joaoantoniocardoso/sct2_projeto1/README.md

# sct2_projeto1
Primeiro projeto de controlador digital da disciplina de Sistemas de Controles 2

Relatório: [Relatorio.pdf](Relatorio.pdf)
