joaoantoniocardoso/sct2_projeto1/controle/SCT2_bloco1/ALL0000/F0000TEK.JPG

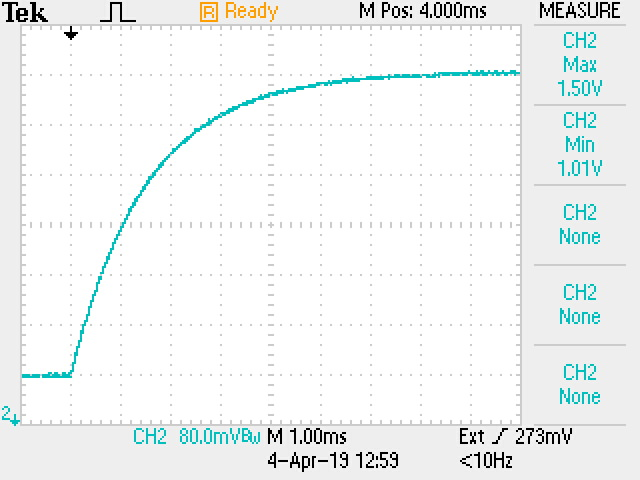
controle/SCT2_bloco1/ALL0000/F0000TEK.JPG
