joaoantoniocardoso/sct2_projeto1/controle/SCT2_bloco1/ALL0001/F0001TEK.JPG

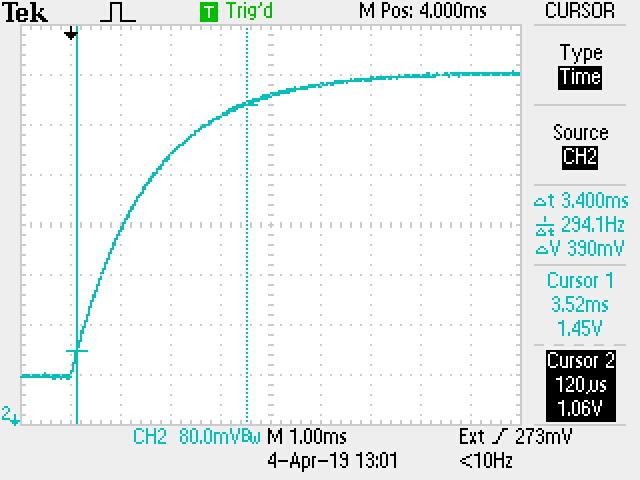
controle/SCT2_bloco1/ALL0001/F0001TEK.JPG
