joaoantoniocardoso/sct2_projeto1/controle/SCT2_bloco2/ALL0002/F0002TEK.JPG

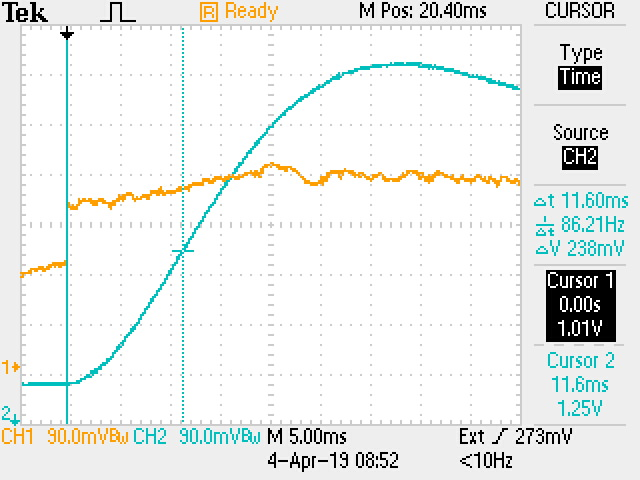
controle/SCT2_bloco2/ALL0002/F0002TEK.JPG
