joaoantoniocardoso/sct2_projeto1/controle/SCT2_bloco2/ALL0003/F0003TEK.JPG

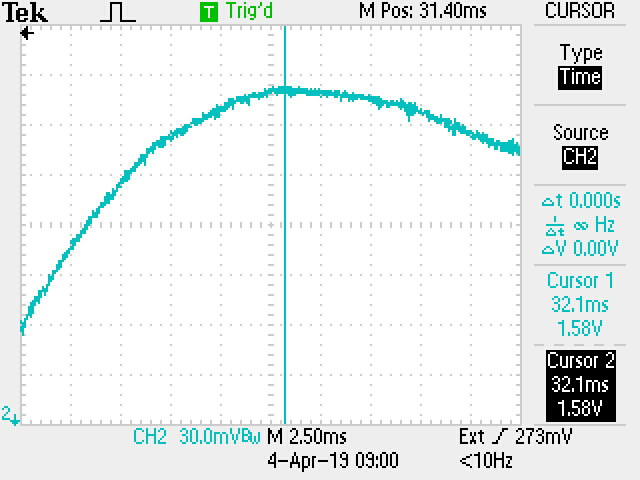
controle/SCT2_bloco2/ALL0003/F0003TEK.JPG
