joaoantoniocardoso/sct2_projeto1/controle/SCT2_bloco2/ALL0004/F0004TEK.JPG

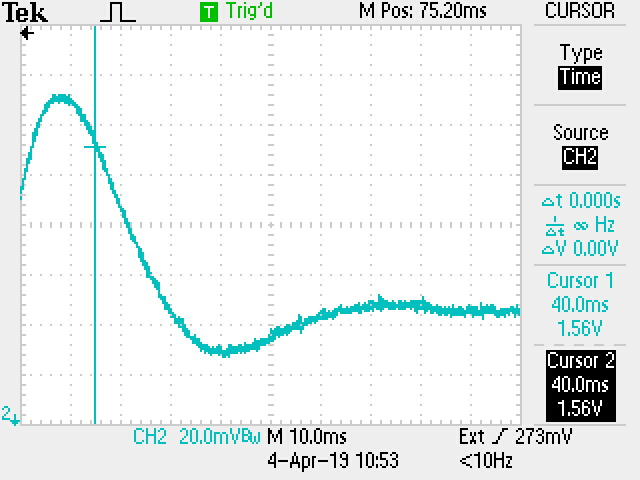
controle/SCT2_bloco2/ALL0004/F0004TEK.JPG
