joaoantoniocardoso/sct2_projeto1/controle/SCT_bloco1ord/ALL0003/F0003TEK.JPG

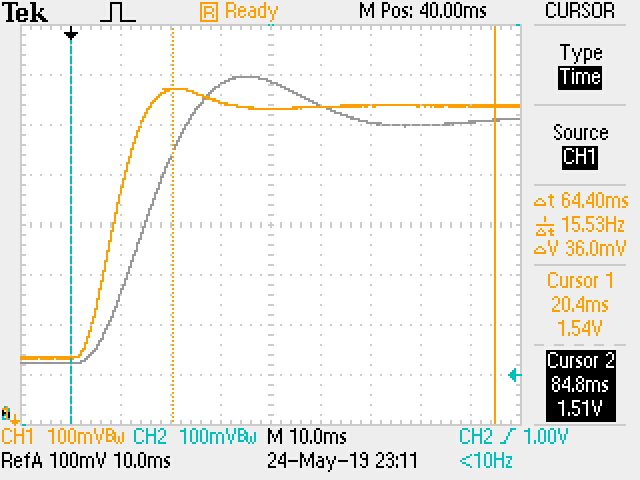
controle/SCT_bloco1ord/ALL0003/F0003TEK.JPG
