joaoantoniocardoso/sct2_projeto1/controle/SCT_completo/ALL0000/F0000TEK.JPG

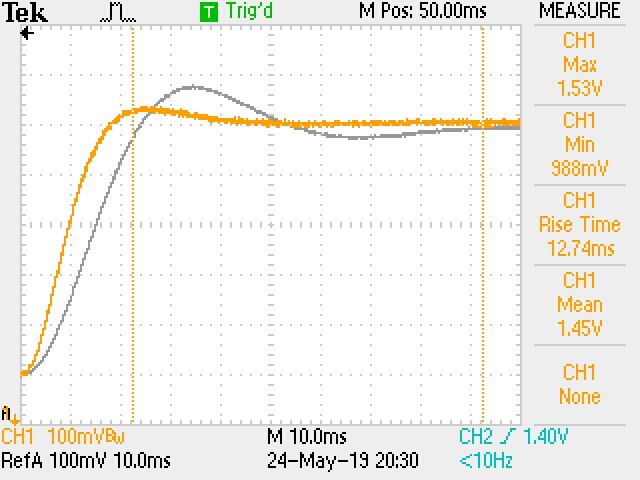
controle/SCT_completo/ALL0000/F0000TEK.JPG
