joaoantoniocardoso/sct2_projeto1/controle/SCT_controlado/ALL0002/F0002TEK.JPG

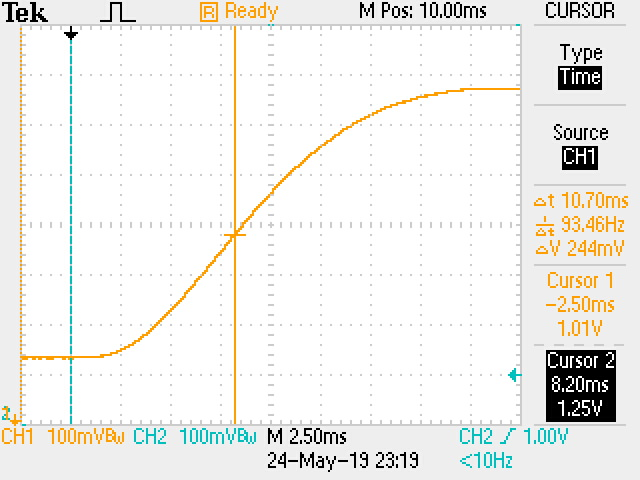
controle/SCT_controlado/ALL0002/F0002TEK.JPG
