joaoantoniocardoso/sct2_projeto1/controle/SCT_controlado/ALL0004/F0004TEK.JPG

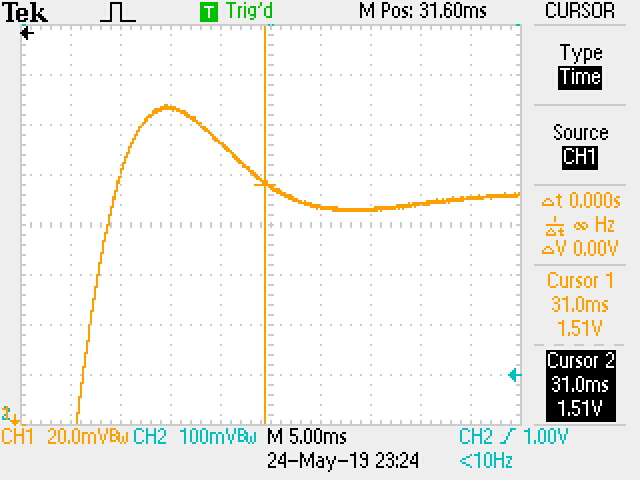
controle/SCT_controlado/ALL0004/F0004TEK.JPG
