joaoantoniocardoso/sct2_projeto1/f28335_ccs7/ExperimentersKit-HWdevPkg/USBDockingStation_BOM [R3].xls

USB-Docking Stn [R3]
 |  |  |  | For planning purposes |  |  | Notes
Item | Description | Digikey Part # | Mouser Part # | Qty | price | ext Price
U1 | FT2232D | 768-1010-1 |  | 1 | $4.00 | $4.00
U2 | TPS79533 - Linear 3.3 Vreg | 296-13810-1 |  | 1 | $1.26 | $1.26
U3 | 93LC46BT SOT23-6 | 93LC46BT-I/OTCT |  | 1 | $0.20 | $0.20
U4 | SN74LVC2G74 SM8 | 296-13273-1 |  | 1 | $0.15 | $0.15
LD1 | LED Green 0805 | 404-1021-1 |  | 1 | $0.03 | $0.03
DA1 | BAW567 Quad Diode Array SOT363 | BAW567DWDICT |  | 1 | $0.26 | $0.26
C1 | CAP ceramic 10u X5R, SMD 0805 | PCC2225TR |  | 1 | $0.05 | $0.05
C2 | CAP ceramic 4u7 X5R, SMD 0805 | 587-1302-2 |  | 1 | $0.05 | $0.05
C3 | CAP ceramic 100n X5R, SMD 0805 | PCC1828TR |  | 1 | $0.01 | $0.01
C4, C5 | CAP ceramic 1u X5R, SMD 0603 | 490-1549-1 |  | 2 | $0.02 | $0.04
C6, C7, C8, C9, C10, C11, C12 | CAP ceramic 100n X5R, SMD 0603 | 587-1245-1 |  | 7 | $0.01 | $0.07
L1 | Inductor 22uH SMD, 0805 | 490-4030-1 |  | 1 | $0.05 | $0.05
X1 | Resonator 6MHz SMD 3 pin | 490-1218-1 |  | 1 | $0.17 | $0.17
R1, R9 | Resistors 470R, 5% - SMD, 0603 |  |  | 2 | $0.01 | $0.02
R2, R3 | Resistors 27R, 5% - SMD, 0603 |  |  | 2 | $0.01 | $0.02
R4, R6 | Resistors 2K2, 5% - SMD, 0603 |  |  | 2 | $0.01 | $0.02
R5 | Resistors 1M, 5% - SMD, 0603 |  |  | 1 | $0.01 | $0.01
R7 | Resistors 10K, 5% - SMD, 0603 |  |  | 1 | $0.01 | $0.01
R8 | Resistors 1K, 5% - SMD, 0603 |  |  | 1 | $0.01 | $0.01
R13 | Resistors 47K, 5% - SMD, 0603 |  |  | 1 | $0.01 | $0.01
R10, R11, R12, R15, R16, R17, R18 | Resistors 2K7, 5% - SMD, 0603 |  |  | 7 | $0.01 | $0.07
R14 | Resistors 1K5, 5% - SMD, 0603 |  |  | 1 | $0.01 | $0.01
SW1 | Miniture SPDT switch PCB mount |  | 108-2AS1T1203-EVX | 1 | $1.97 | $1.97
JP1 | Power jack 2.5 x 5.5 mm | CP-002BH |  | 1 | $0.24 | $0.24
JP2 | USB Connector Type B PCB mount | ED90064 |  | 1 | $0.73 | $0.73
J1 | 100 pin DIMM socket - Molex 0876301001 |  | 538-87630-1001 | 1 | $0.68 | $0.68
J2 | standard 0.1" pin (DIL) headers 14 pin (2x7) |  |  |  |  |  | Remove pin 6
J3, 4,5,6,7 | standard 0.1" pin (SIL) headers cut to length
J8 | standard 0.1" 2 pin (SIL)
Boot-280xx | standard 0.1" pin headers 9 pins (3x3) |  |  |  |  |  | Make up with SIL or other combination
Boot-2833x | standard 0.1" pin headers 12 pins (3x4) |  |  |  |  |  | Make up with SIL or other combination
GND x 4 | standard 0.1" pin (SIL) headers cut to length
3V3 x 2 | standard 0.1" pin (SIL) headers cut to length
5V x 1 | standard 0.1" pin (SIL) headers cut to length
Rubber Feet | Bumpon hemisphere 0.44”x 0.2” Clear | SJ5303-7 |  | 4 | $0.06 | $0.24
 |  | TOTAL |  |  |  | $10.38
