joaoantoniocardoso/sct2_projeto1/f28335_ccs7/CC2833xHWdevPkg/F28335controlCARD HWDevPkg PGF [R1.0]/F28335controlCARD-BOM(R2) 5-27.xls

F28335 controlCARD BOM - Rel 2
Updated May 27, 2010
Item | Description | Digikey Part #
C1-15, C34,36, 39-51 | CAP ceramic 100n X5R SMD 0603
C32 | CAP ceramic 100n X5R SMD 0603
C16-C27 | CAP ceramic 3n3 X5R SMD 0603
C30,31 | CAP ceramic 2u2 X7R SMD 0603
C33,C53,C54 | CAP ceramic 33p X7R SMD 0603
C28,29 | CAP ceramic 10u 6.3V X5R SMD 1206 | 490-1806-2
C37, 38 | CAP ceramic 22u X5R SMD1206 | 587-1334-2
C35, C52 | CAP Tant 47u 10V SMD (3216-12) | 511-1500-2
L1-L18 | Inductor 22uH SMD 0805 | 490-1054-1-ND
L19 | Inductor 2u2H SMD (see data sheet) | 445-3215-2 | Note: If not in stock, use 3u3 H
L20 | Inductor 3u3H SMD (see data sheet) | 445-3216-2
R2 | Resistors 22K1, 1% - SMD, 0603
R8 | Resistors 220K, 1% - SMD, 0603
R9 | Resistors 48K7, 1% - SMD, 0603
R10 | Resistors 147K, 1% - SMD, 0603
R11 | Resistors 68K0, 1% - SMD, 0603
R15 | Resistors 2k2, 5% - SMD, 0603
R13 | Resistors 0R 5% - SMD, 0805
R6,7,21 | Resistors 680R, 5% - SMD, 0603
R17 | Resistors 2K, 5% - SMD, 0603
R18 | Resistors 22K, 5% - SMD, 0603
R19 | Resistors 10K, 5% - SMD, 0603
R20 | Resistors 0R 5% - SMD, 0603 (Do NOT populate)
R33 | Resistor 0R 5% - SMD, 0603
R34 | Resistors 0R 5% - SMD, 0603 (Do NOT populate)
R22, 23 | Resistors 4K7, 5% - SMD, 0603
R24 | Resistors 0R 5% - SMD, 0805
R25, R26, R27, R28 | Resistors 820R, 1% - SMD, 0603
R29, R30, R31, R32 | Resistors 3K3, 1% - SMD, 0603
SW2 | 4 switch pack | Manf part number (CT2184LPST)
SW1 | switch | 563-1004-1-ND
RN1,2 | Resistor network 56R 5% - SMD, as small as needed | Y1560CT
RN3 | Resistor network 33R 5% - SMD, as small as needed | Y1330CT
X1 | crystal - 30 MHz - SMD (NX5032GA-30) | 644-1043-1-ND
DN1,2,3 | Diodes, clamping, NUP4201MR6 TSOP-6 | NUP4201MR6T1GOSTR
LD1 | LED SMD 0805 - Green | 404-1021-1
LD2,3 | LEDs SMD 0805 - Red | 404-1017-1
U1 | TMS320F2833x (TI) SMD (176 BGA "ZJZ") or (176 pin LQFP "PGF" package (non socketed))
U2 | TPS62400-DRCT (TI) | 296-20690-1
U4 | ISO7221CDR (TI) | 296-21955-1
U3 | SN74LVC2G07 (TI) | 296-13494-2
U5 | MAX3221 (TI) | 296-19825-2
U6 | TPS3828-DBVT (TI) | 296-2638-1
