joaoantoniocardoso/sct2_projeto1/hardware/main/main.pdf

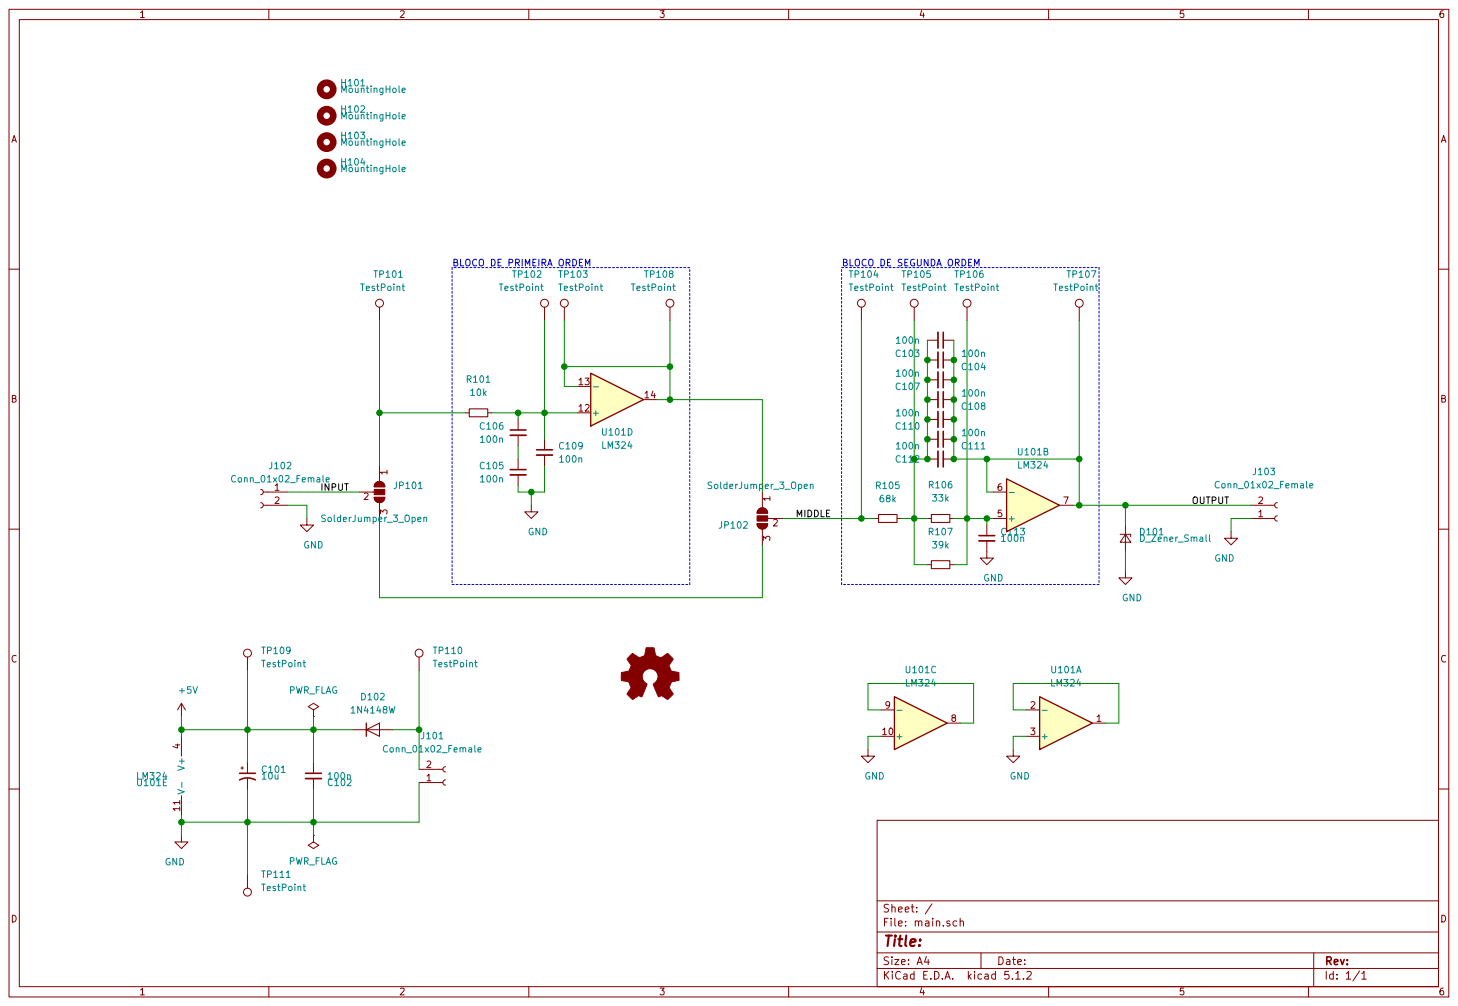
[picture p45: page 1]

Id: 1/1 Title: File: main.sch Sheet: / R105
