joaoantoniocardoso/sct2_projeto1/hardware/simulations/Draft1.asc

C1: cap; 1p
R1: res; 50
R2: res; 50
V1: voltage-; PULSE(0 5 0 13e-9 13e-9 2.5e-07 5e-07)
Named nets: 0, in, out
.tran 0 5000e-9 0 1e-8
