joaoantoniocardoso/sct2_projeto1/hardware/simulations/Draft2.asc

C1: cap; 150n
R1: res; 10k
R2: res; 10k
U1: LM324_NS
Named nets: 0, VCC, A, C
