joaoantoniocardoso/sct2_projeto1/hardware/simulations/planta_equivalente_alimentacao_simples.asc

C1: cap; 150n
C2: cap; 150n
R1: res; 10k
R2: res; 10k
R5: res; 10k
R6: res; 10k
R7: res; 10k
R8: res; 10k
sig1: voltage-; PULSE(0 3.3 0 1n 1n 500e-6 1000e-6)
sig: voltage-; ac 1
U1: LM324_NS
U3: LM324_NS
U4: LM324_NS
V1: voltage-; 5
V2: voltage-; 12
V3: voltage-; -5
Named nets: VCC, 0, VEE, B_, A, C_, C, VCC2
;.ac dec 10000 1 10000
.tran 0 0.04 0.01
