joaoantoniocardoso/sct2_projeto1/controle/spice/main.asc

C1: cap; 150n
C2: cap; 150n
C3: cap; 700n
R1: res; 10k
R3: res; 18k
R4: res; 68k
U1: LM324_NS
U2: LM324_NS
Named nets: 0, 5V, A, B, C
