joaoantoniocardoso/sct2_projeto1/(list of files, drawings)

Other design files:
f28335_ccs7/ExperimentersKit-HWdevPkg/!Legacy_DockingStation[R2]/BH28xxxDockingStn[R2].pcb
f28335_ccs7/ExperimentersKit-HWdevPkg/!Legacy_DockingStation[R2]/BH28xxxQuickSpinTemplate.pcb
f28335_ccs7/ExperimentersKit-HWdevPkg/USB-DockingStn[R3].pcb
