joaoantoniocardoso/sct2_projeto1/hardware/main/main.kicad_pcb

## KiCad design hardware/main/main.kicad_pcb (2019-05-27)

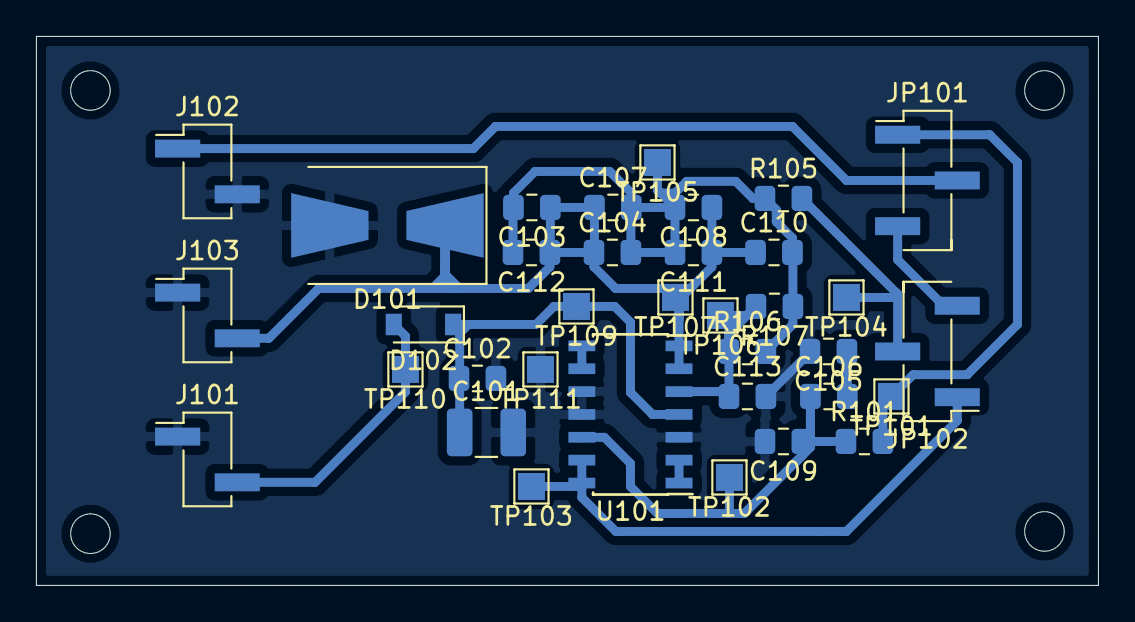
[picture p46: board main.kicad_pcb from below]

Board: 2 copper layers, 59.0 x 30.5 mm, 39 parts (35 on the bottom side), 15 nets.

Parts:
C101: 10u; C_1210_3225Metric_Pad1.42x2.65mm_HandSolder
C102, C103, C104, C105, C106, C107, C108, C109, C110, C111, C112, C113: 100n; C_0805_2012Metric_Pad1.15x1.40mm_HandSolder
D101: D_Zener_Small; D_SMB-SMC_Universal_Handsoldering
D102: 1N4148W; D_SOD-123
H101, H102, H103, H104: MountingHole; MountingHole_2.2mm_M2
J101, J102, J103: Conn_01x02_Female; PinHeader_1x02_P2.54mm_Vertical_SMD_Pin1Left
JP101, JP102: SolderJumper_3_Open; PinHeader_1x03_P2.54mm_Vertical_SMD_Pin1Left
R101: 10k; R_0805_2012Metric_Pad1.15x1.40mm_HandSolder
R105: 68k; R_0805_2012Metric_Pad1.15x1.40mm_HandSolder
R106: 33k; R_0805_2012Metric_Pad1.15x1.40mm_HandSolder
R107: 39k; R_0805_2012Metric_Pad1.15x1.40mm_HandSolder
TP101, TP102, TP103, TP104, TP105, TP106, TP107, TP109, TP110, TP111: TestPoint; TestPoint_Pad_1.5x1.5mm
U101: LM324; SOIC-14_3.9x8.7mm_P1.27mm

Connections:
+5V: C101.1, C102.1, D102.1, TP109.1, U101.4
/INPUT: J102.1, JP101.2
/MIDDLE: JP102.2, R105.2, TP104.1
/OUTPUT: C103.1, C104.1, C107.1, C108.1, C110.1, C111.1, C112.1, D101.1, J103.2, TP107.1, U101.6, U101.7
GND: C101.2, C102.2, C105.2, C109.2, C113.2, D101.2, J101.1, J102.2, J103.1, TP111.1, U101.3, U101.10, U101.11
unnamed: C103.2, C104.2, C107.2, C108.2, C110.2, C111.2, C112.2, R105.1, R106.2, R107.1, TP105.1
unnamed: C105.1, C106.2
unnamed: C106.1, C109.1, R101.1, TP102.1, U101.12
unnamed: C113.1, R106.1, R107.2, TP106.1, U101.5
unnamed: D102.2, J101.2, TP110.1
unnamed: JP101.1, R101.2, TP101.1
unnamed: JP101.3, JP102.3
unnamed: JP102.1, TP103.1, U101.13, U101.14
unnamed: U101.1, U101.2
unnamed: U101.8, U101.9
