joaoantoniocardoso/sct2_projeto1/f28335_ccs7/basic_F28335/main.c

/*
 * main.c
 *
 *  Created on: Jun 2, 2017
 *      Author: João Antônio Cardoso
 *
 *  Description: Firmware para o Projeto 1 de Sistemas de Controle 2
 *
 *  Instructions:
 *      1) Conectar a interrupção do pino GPIO60 como trigger no canal
 *      Ext. Trig. do osciloscópio
 *      2) Conectar a saída da planta no canal 1 do osciloscópio
 *      3) Conectar a saída epwm1 na entrada da planta e no canal 2 do
 *      osciloscópio
 *
 *  References: http://www.ti.com/product/TMS320F28335/technicaldocuments
 *
 */

#include "DSP28x_Project.h"
#include "my_adc.h"
#include "my_scia.h"
#include "my_epwm.h"
#include "my_debugpins.h"

#define MY_DEBUG_

//void serial_debug(void);

void init(void){

    DINT;   // Disable Global interrupt

    // Disable CPU interrupts and clear all CPU interrupt flags:
    IER = 0x0000;
    IFR = 0x0000;

    // É necessário para as funções que utilizam macros dos .asm, como o InitAdc.
    memcpy(&RamfuncsRunStart, &RamfuncsLoadStart, &RamfuncsLoadEnd - &RamfuncsLoadStart);
    InitFlash();    // call InitFlash in RAM (SARAM - L0)

    InitSysCtrl();

    InitPieCtrl();
    InitPieVectTable();
    my_epwm_init();
    my_adc_init();

#ifdef MY_DEBUG_
    my_scia_init();
#endif

    // Enable global Interrupts and higher priority real-time debug events:
    EINT;   // Enable Global interrupt INTM
    ERTM;   // Enable Global realtime interrupt DBGM
}

#define VO1     1.0f
#define VO2     1.5f
#define WAIT_S  0.5f

extern double r[4];

void main(void)
{
    init();

    float dt[2] = {VO1, VO2};

    Uint32 wait_us = WAIT_S * 1000000;

    Uint32 i = 0;

    init_dbgpin1();
    set_dbgpin1();

    init_dbgpin2();

    for(;;){
        r[3] = dt[i];

        tgl_dbgpin1();          // CHECK PIN 60

        DELAY_US(wait_us);
        if(i++) i = 0;
    }

}
