joaoantoniocardoso/sct2_projeto1/(commit log)

2019-04-03 Planta adicionada, mas contém erros:
    O principal erro detectado é que para utilizar alimentação simples, a topologia
    do bloco de primeira ordem deve ser alterada, no caso deste commit a
    topologia ainda não foi alterada.
    [main.kicad_pcb, main.sch]
2019-04-03 Circuito modificado para alimentação simples.
    [main.sch]
2019-04-03 Simulação da topologia de alimentação simples e sua equivalencia com a topologia inicialmente proposta pelo professor
2019-04-03 Nenhum ganho é necessário na estrutura para ser equivalente. A análise em freq. estava errada.
2019-04-03 PCB updated to single supply topology
    [main.kicad_pcb, main.sch]
2019-04-03 ERC -> ok
    [main.kicad_pcb]
2019-04-03 Firmware inicial adicionado.
    [BH28xxxDockingStn-BOM[R2].xls, BH28xxxDockingStn[R2].pcb, BH28xxxDockingStn[R2].sch, BH28xxxQuickSpinTemplate.pcb, Example_freqcal.xls, Example_posspeed.xls, F28335controlCARD-BOM(R2) 5-27.xls, F28335controlCARD-BOM[R1.2].xls]
2019-04-03 Painel plotado para confecção da placa por transferência térmica
    [main.kicad_pcb]
